Bacman88/TerraLight/schematy/kicad9/TerraLight-mini/podglad.png

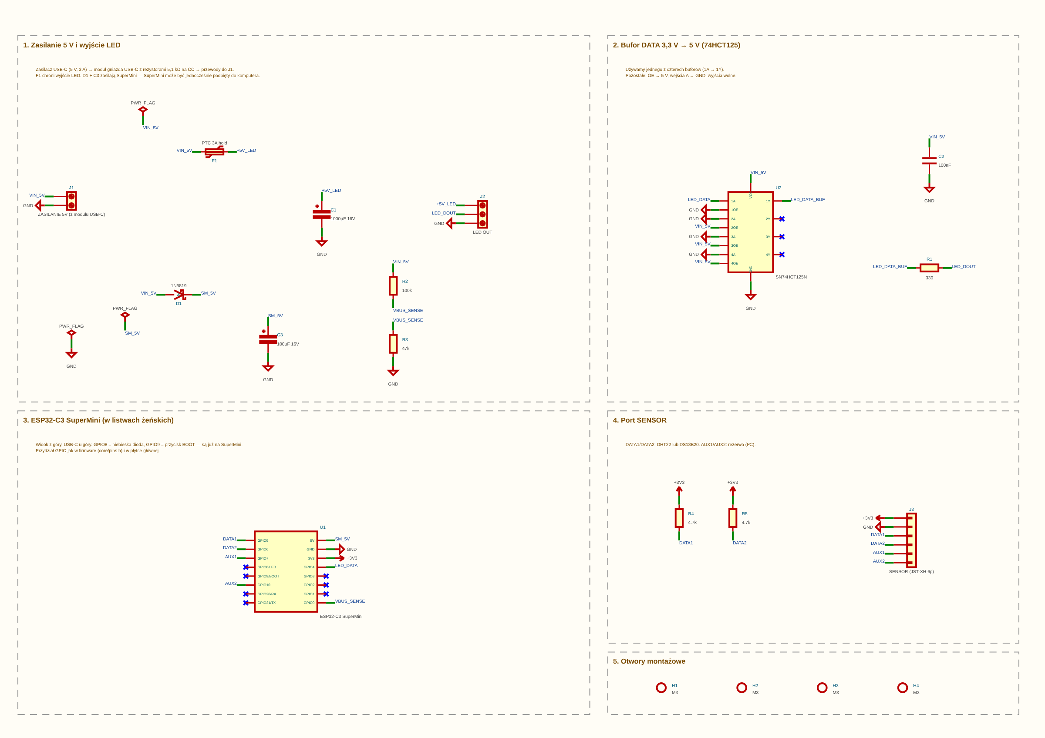
schematy/kicad9/TerraLight-mini/podglad.png
