Bacman88/TerraLight/(list of files, drawings)

Other design files:
schematy/easyeda/TerraLight_Minimal_EasyEDA_STD_DRAFT.json
