Bacman88/TerraLight/schematy/kicad9/TerraLight-main/TerraLight-main.kicad_sch

## KiCad design schematy/kicad9/TerraLight-main/TerraLight-main.kicad_sch (2026-10-15)

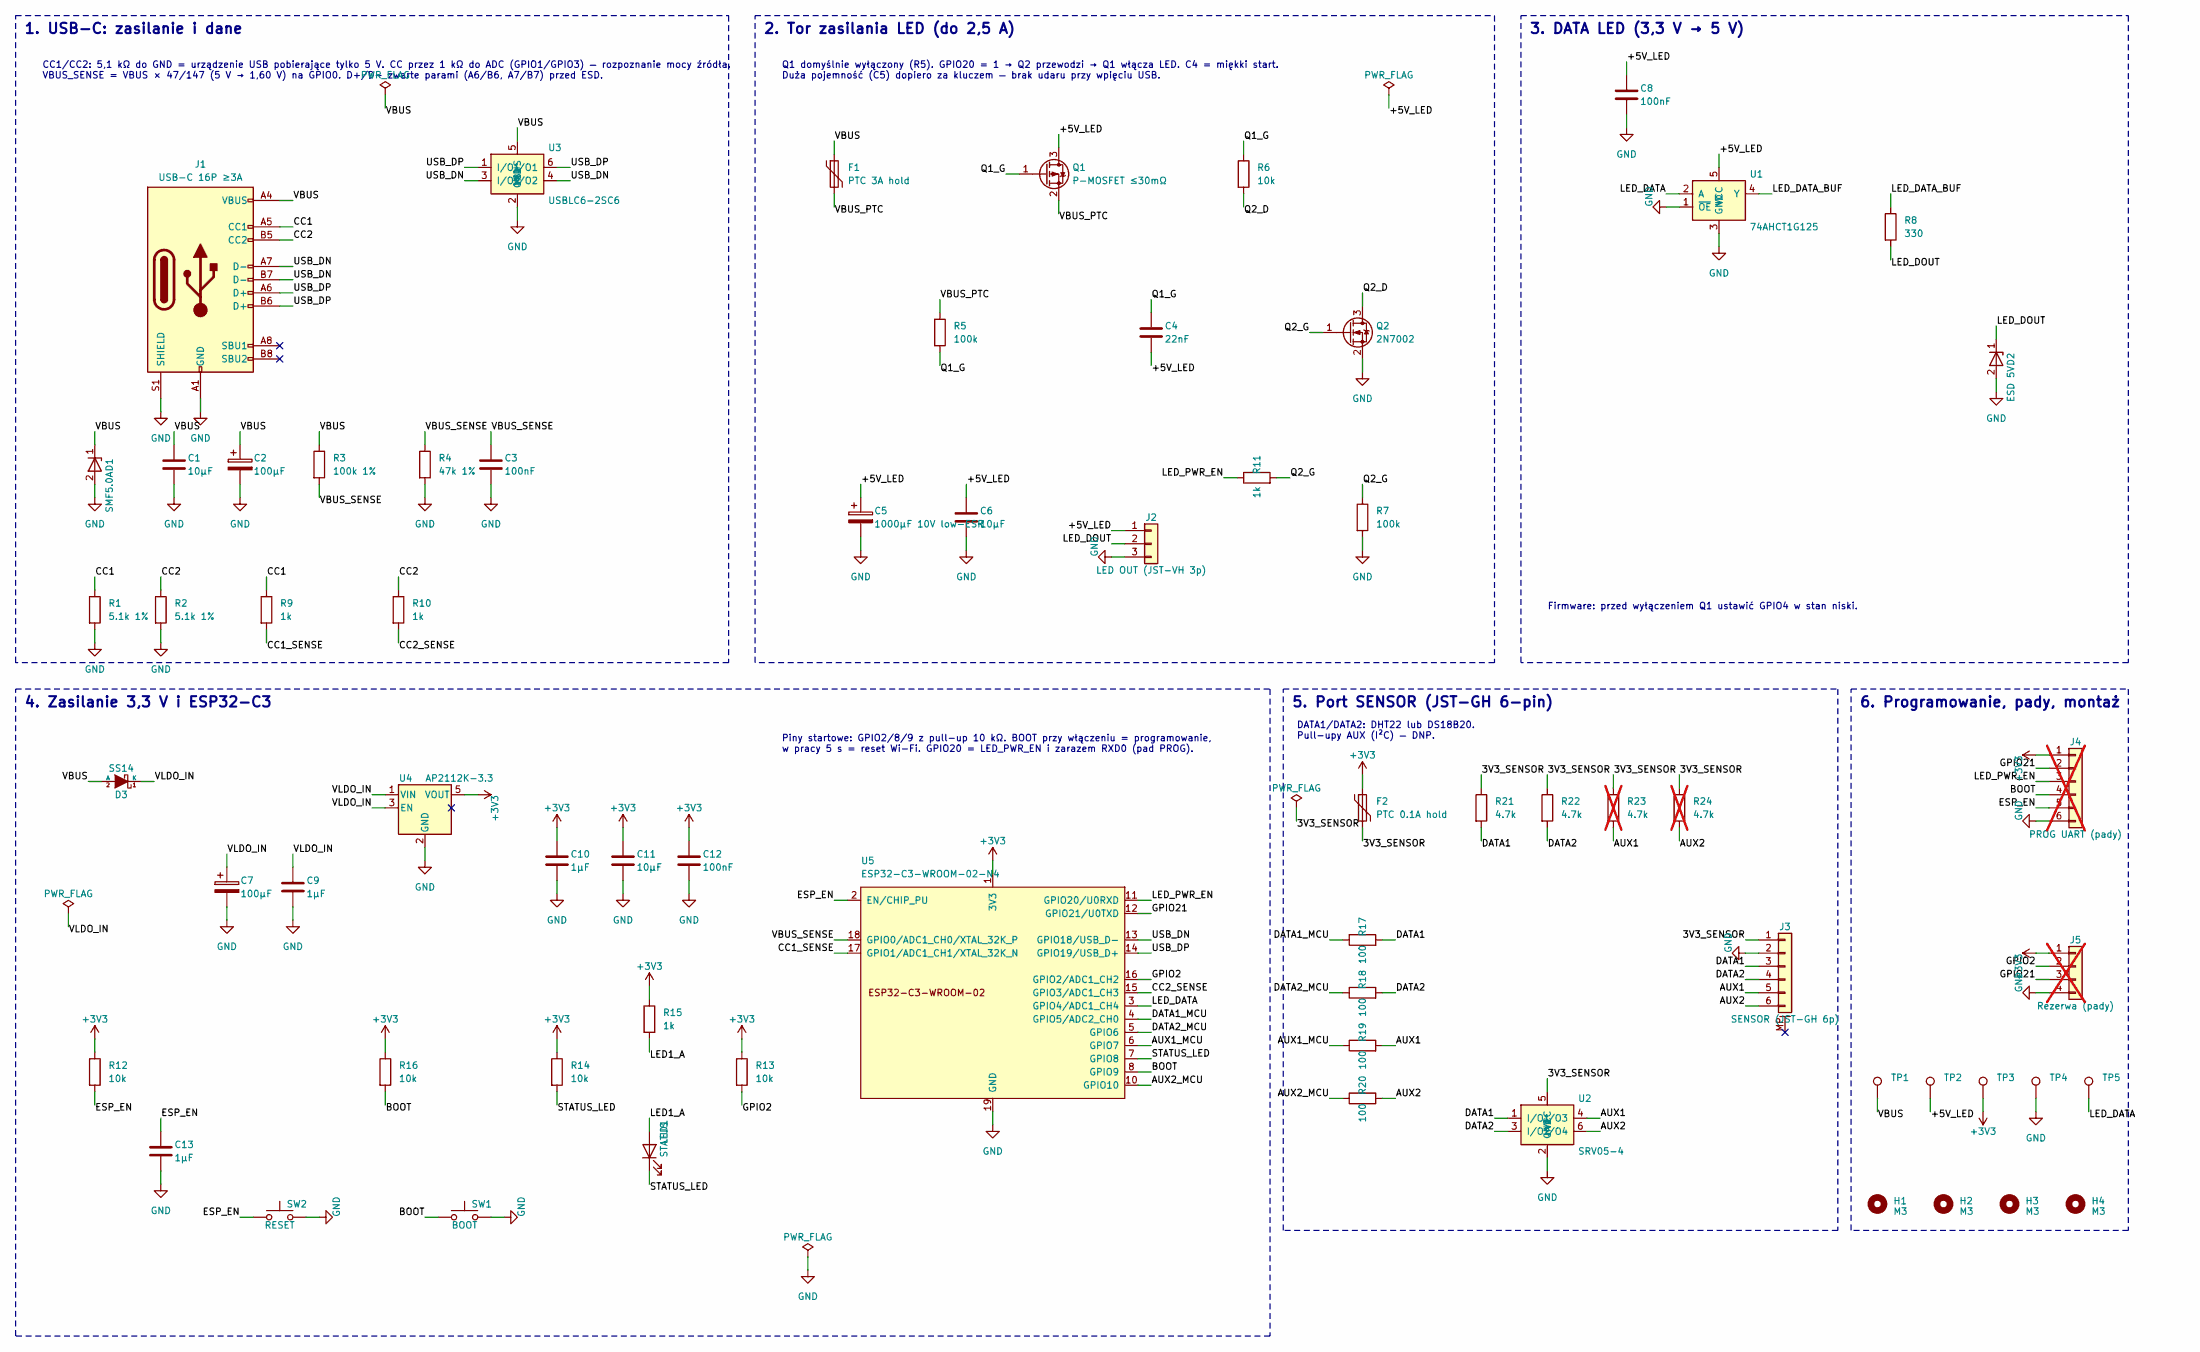
[picture p2: schematic TerraLight-main.kicad_sch]

Parts:
C1, C6, C11: 10µF; C_0805_2012Metric; MPN Samsung CL21A106KAYNNNE
C2, C7: 100µF; CP_Elec_6.3x7.7; MPN [100 µF ≥10 V, SMD Ø6,3 mm]
C3, C8, C12: 100nF; C_0805_2012Metric; MPN Samsung CL21B104KBCNNNC
C4: 22nF; C_0805_2012Metric; MPN Samsung CL21B223KBANNNC
C5: 1000µF 10V low-ESR; CP_Elec_10x10.5; MPN [1000 µF 10 V low-ESR, SMD Ø10 mm]
C9, C10, C13: 1µF; C_0805_2012Metric; MPN Samsung CL21B105KAFNNNE
D1: SMF5.0A; D_SOD-123F; MPN Littelfuse SMF5.0A
D2: ESD 5V; D_SOD-323; MPN Nexperia PESD5V0S1BA
D3: SS14; D_SMA; MPN SS14
F1: PTC 3A hold; Fuse_1812_4532Metric; MPN Bourns MF-MSMF300-2 [lub inny PTC 1812,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
F2: PTC 0.1A hold; Fuse_0805_2012Metric; MPN Littelfuse 0805L010
H1, H2, H3, H4: M3; MountingHole_3.2mm_M3
J1: USB-C 16P ≥3A; USB_C_Receptacle_HRO_TYPE-C-31-M-12; MPN HRO TYPE-C-31-M-12
J2: LED OUT (JST-VH 3p); JST_VH_S3P-VH_1x03_P3.96mm_Horizontal; MPN JST S3P-VH(LF)(SN)
J3: SENSOR (JST-GH 6p); JST_GH_SM06B-GHS-TB_1x06-1MP_P1.25mm_Horizontal; MPN JST SM06B-GHS-TB(LF)(SN)
J4: PROG UART (pady); PinHeader_1x06_P2.54mm_Vertical; MPN [listwa 1×6 2,54 mm — opcjonalnie]; not fitted
J5: Rezerwa (pady); PinHeader_1x04_P2.54mm_Vertical; MPN [listwa 1×4 2,54 mm — opcjonalnie]; not fitted
LED1: STATUS; LED_0805_2012Metric; MPN [LED 0805, dowolny kolor]
Q1: P-MOSFET ≤30mΩ; SOT-23; MPN Vishay Si2333DDS [sprawdzić RDS(on) i p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
Q2: 2N7002; SOT-23; MPN 2N7002
R1, R2: 5.1k 1%; R_0805_2012Metric; MPN Yageo RC0805FR-075K1L
R3: 100k 1%; R_0805_2012Metric; MPN Yageo RC0805FR-07100KL
R4: 47k 1%; R_0805_2012Metric; MPN Yageo RC0805FR-0747KL
R5, R7: 100k; R_0805_2012Metric; MPN Yageo RC0805FR-07100KL
R6, R12, R13, R14, R16: 10k; R_0805_2012Metric; MPN Yageo RC0805FR-0710KL
R8: 330; R_0805_2012Metric; MPN Yageo RC0805FR-07330RL
R9, R10, R11, R15: 1k; R_0805_2012Metric; MPN Yageo RC0805FR-071KL
R17, R18, R19, R20: 100; R_0805_2012Metric; MPN Yageo RC0805FR-07100RL
R21, R22: 4.7k; R_0805_2012Metric; MPN Yageo RC0805FR-074K7L
R23, R24: 4.7k; R_0805_2012Metric; MPN Yageo RC0805FR-074K7L; not fitted
SW1: BOOT; SW_SPST_TL3342; MPN E-Switch TL3342 [sprawdzić wariant]
SW2: RESET; SW_SPST_TL3342; MPN E-Switch TL3342 [sprawdzić wariant]
TP1: VBUS; TestPoint_Pad_D1.5mm
TP2: +5V_LED; TestPoint_Pad_D1.5mm
TP3: +3V3; TestPoint_Pad_D1.5mm
TP4: GND; TestPoint_Pad_D1.5mm
TP5: LED_DATA; TestPoint_Pad_D1.5mm
U1: 74AHCT1G125; SOT-23-5; MPN TI SN74AHCT1G125DBVR
U2: SRV05-4; SOT-23-6; MPN Semtech SRV05-4
U3: USBLC6-2SC6; SOT-23-6; MPN ST USBLC6-2SC6
U4: AP2112K-3.3; SOT-23-5; MPN Diodes AP2112K-3.3TRG1
U5: ESP32-C3-WROOM-02-N4; ESP32-C3-WROOM-02_HandSolder; MPN Espressif ESP32-C3-WROOM-02-N4

Connections:
3V3_SENSOR: F2.2, J3.1, R21.1, R22.1, R23.1, R24.1, U2.5 (VCC)
+3V3: C10.1, C11.1, C12.1, F2.1, J4.1, J5.1, R12.1, R13.1, R14.1, R15.1, R16.1, TP3.1, U4.5 (VOUT), U5.1 (3V3)
+5V_LED: C4.2, C5.1, C6.1, C8.1, J2.1, Q1.3 (D), TP2.1, U1.5 (VCC)
AUX1: J3.5, R19.2, R23.2, U2.4 (I/O3)
AUX1_MCU: R19.1, U5.6 (GPIO7)
AUX2: J3.6, R20.2, R24.2, U2.6 (I/O4)
AUX2_MCU: R20.1, U5.10 (GPIO10)
BOOT: J4.4, R16.2, SW1.1, U5.8 (GPIO9)
CC1: J1.A5 (CC1), R1.1, R9.1
CC1_SENSE: R9.2, U5.17 (GPIO1/ADC1_CH1/XTAL_32K_N)
CC2: J1.B5 (CC2), R2.1, R10.1
CC2_SENSE: R10.2, U5.15 (GPIO3/ADC1_CH3)
DATA1: J3.3, R17.2, R21.2, U2.1 (I/O1)
DATA1_MCU: R17.1, U5.4 (GPIO5/ADC2_CH0)
DATA2: J3.4, R18.2, R22.2, U2.3 (I/O2)
DATA2_MCU: R18.1, U5.5 (GPIO6)
ESP_EN: C13.1, J4.5, R12.2, SW2.1, U5.2 (EN/CHIP_PU)
GND: C1.2, C2.2, C3.2, C5.2, C6.2, C7.2, C8.2, C9.2, C10.2, C11.2, C12.2, C13.2, D1.2 (A), D2.2 (A), J1.A1 (GND), J1.A12 (GND), J1.B1 (GND), J1.B12 (GND), J1.S1 (SHIELD), J2.3, J3.2, J4.6, J5.4, Q2.2 (S), R1.2, R2.2, R4.2, R7.2, SW1.2, SW2.2, TP4.1, U1.1 (~OE), U1.3 (GND), U2.2 (GND), U3.2 (GND), U4.2 (GND), U5.9 (GND), U5.19 (GND)
GPIO2: J5.2, R13.2, U5.16 (GPIO2/ADC1_CH2)
GPIO21: J4.2, J5.3, U5.12 (GPIO21/U0TXD)
LED1_A: LED1.2 (A), R15.2
LED_DATA: TP5.1, U1.2 (A), U5.3 (GPIO4/ADC1_CH4)
LED_DATA_BUF: R8.1, U1.4 (Y)
LED_DOUT: D2.1 (K), J2.2, R8.2
LED_PWR_EN: J4.3, R11.1, U5.11 (GPIO20/U0RXD)
Q1_G: C4.1, Q1.1 (G), R5.2, R6.1
Q2_D: Q2.3 (D), R6.2
Q2_G: Q2.1 (G), R7.1, R11.2
STATUS_LED: LED1.1 (K), R14.2, U5.7 (GPIO8)
USB_DN: J1.A7 (D-), J1.B7 (D-), U3.3 (I/O2), U3.4 (I/O2), U5.13 (GPIO18/USB_D-)
USB_DP: J1.A6 (D+), J1.B6 (D+), U3.1 (I/O1), U3.6 (I/O1), U5.14 (GPIO19/USB_D+)
VBUS: C1.1, C2.1, D1.1 (K), D3.2 (A), F1.1, J1.A4 (VBUS), J1.A9 (VBUS), J1.B4 (VBUS), J1.B9 (VBUS), R3.1, TP1.1, U3.5 (VBUS)
VBUS_PTC: F1.2, Q1.2 (S), R5.1
VBUS_SENSE: C3.1, R3.2, R4.1, U5.18 (GPIO0/ADC1_CH0/XTAL_32K_P)
VLDO_IN: C7.1, C9.1, D3.1 (K), U4.1 (VIN), U4.3 (EN)

Notes on the sheet:
1. USB-C: zasilanie i dane
2. Tor zasilania LED (do 2,5 A)
3. DATA LED (3,3 V → 5 V)
4. Zasilanie 3,3 V i ESP32-C3
5. Port SENSOR (JST-GH 6-pin)
6. Programowanie, pady, montaż
CC1/CC2: 5,1 kΩ do GND = urządzenie USB pobierające tylko 5 V. CC przez 1 kΩ do ADC (GPIO1/GPIO3) — rozpoznanie mocy źródła. VBUS_SENSE = VBUS × 47/147 (5 V → 1,60 V) na GPIO0. D+/D- zwarte parami (A6/B6, A7/B7) przed ESD.
Q1 domyślnie wyłączony (R5). GPIO20 = 1 → Q2 przewodzi → Q1 włącza LED. C4 = miękki start. Duża pojemność (C5) dopiero za kluczem — brak udaru przy wpięciu USB.
Firmware: przed wyłączeniem Q1 ustawić GPIO4 w stan niski.
Piny startowe: GPIO2/8/9 z pull-up 10 kΩ. BOOT przy włączeniu = programowanie, w pracy 5 s = reset Wi-Fi. GPIO20 = LED_PWR_EN i zarazem RXD0 (pad PROG).
DATA1/DATA2: DHT22 lub DS18B20. Pull-upy AUX (I²C) — DNP.
