Bacman88/TerraLight/schematy/kicad9/TerraLight-mini/TerraLight-mini.kicad_sch

## KiCad design schematy/kicad9/TerraLight-mini/TerraLight-mini.kicad_sch (2026-10-15)

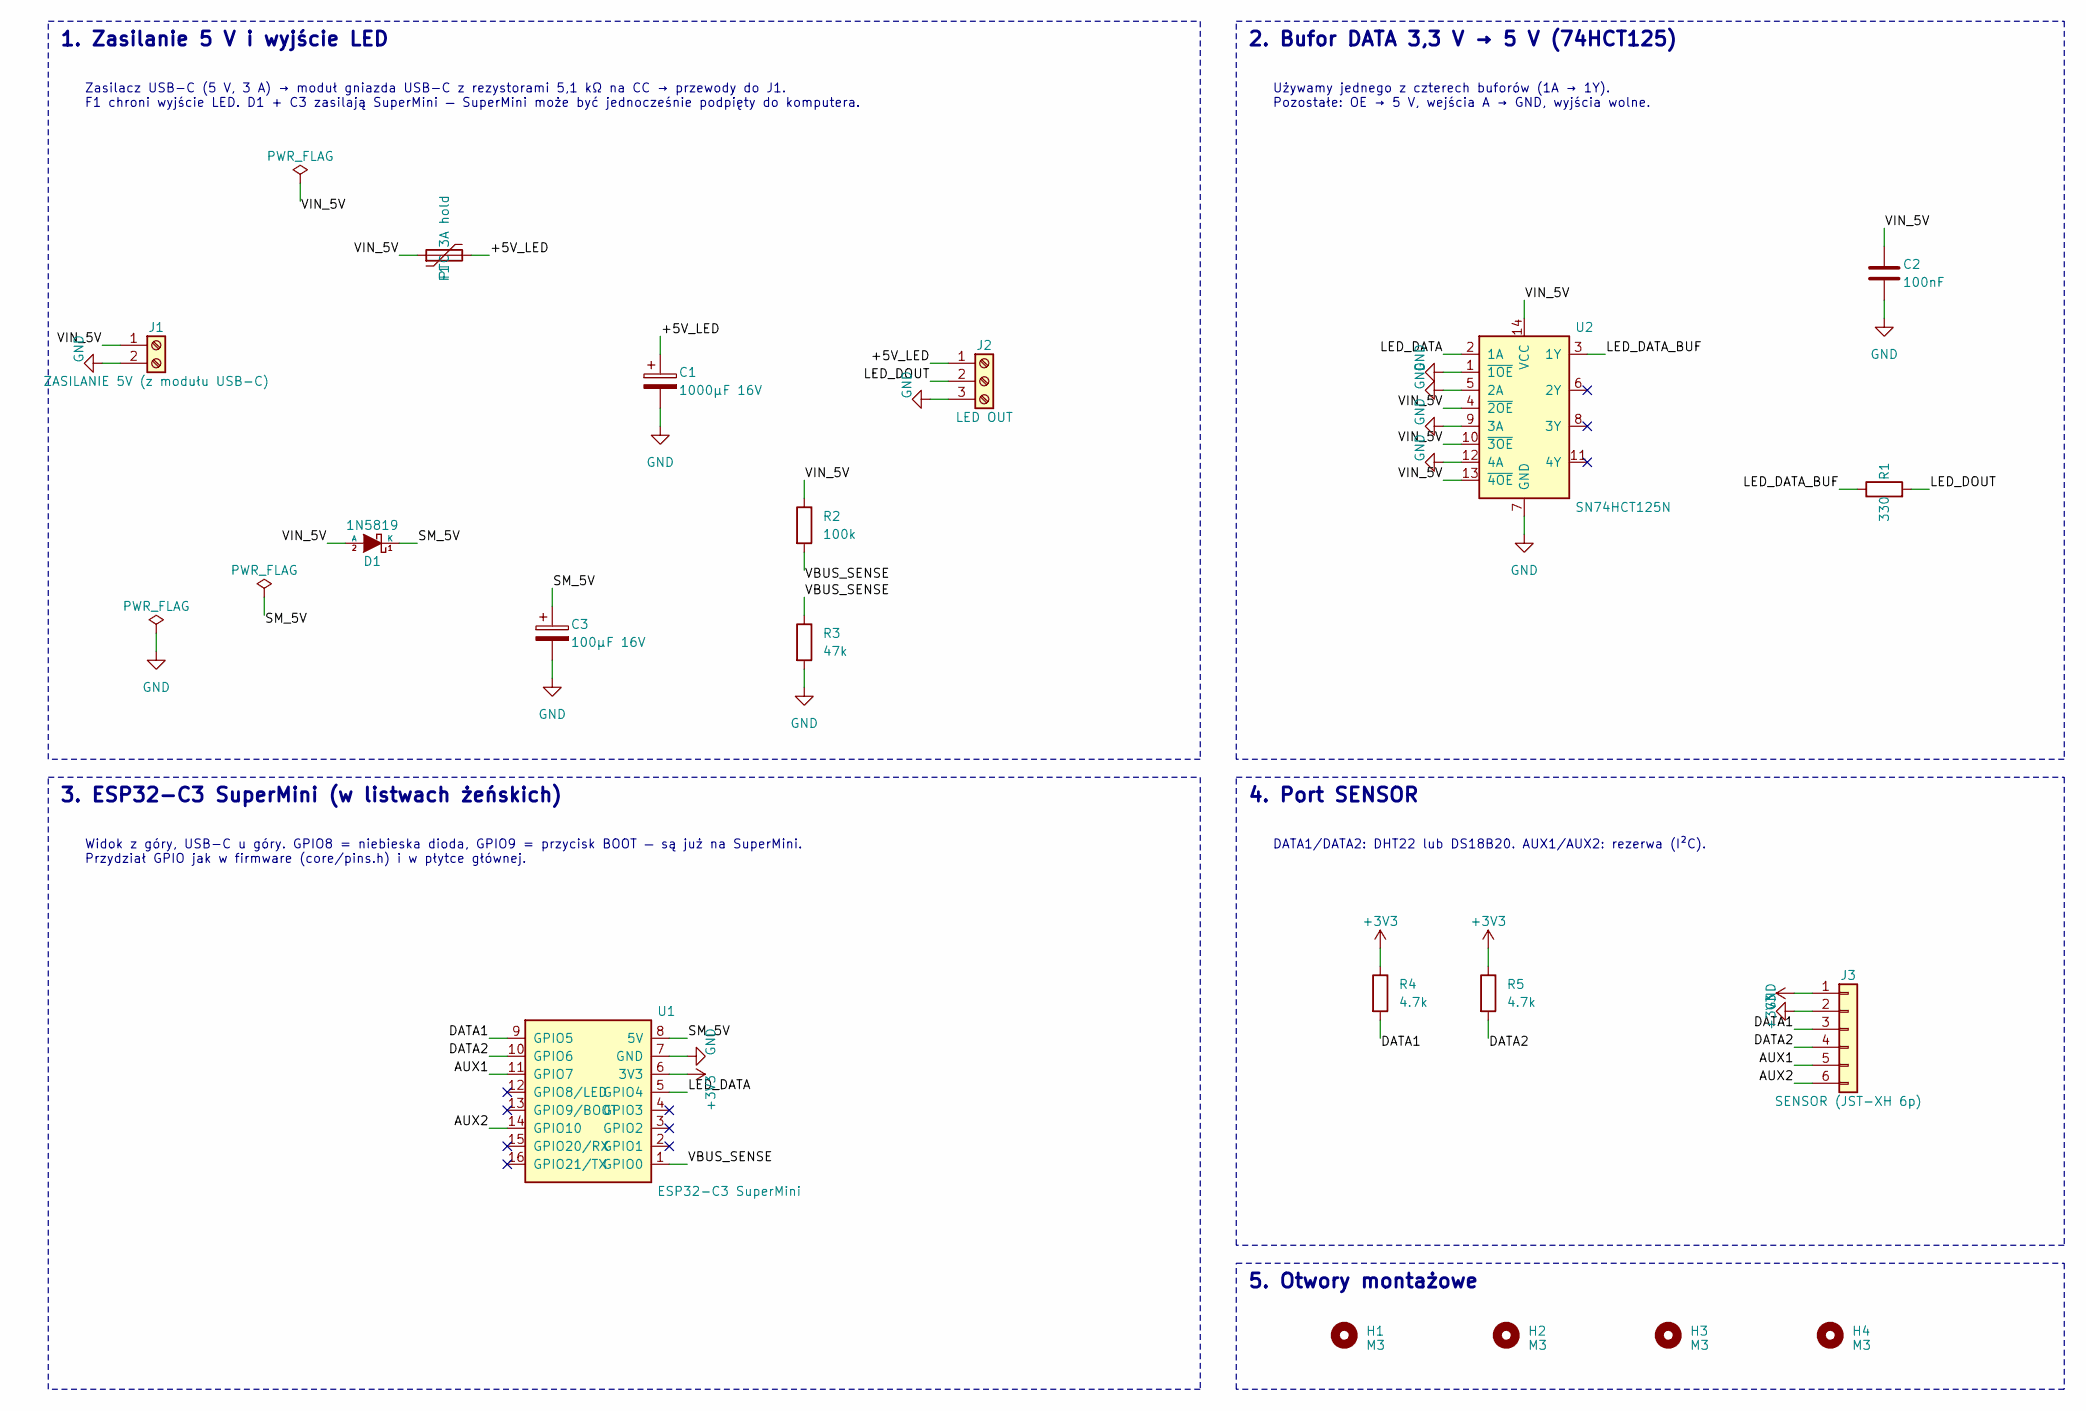
[picture p3: schematic TerraLight-mini.kicad_sch]

Parts:
C1: 1000µF 16V; CP_Radial_D10.0mm_P5.00mm; MPN [1000 µF 16 V, przewlekany Ø10 mm, rast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
C2: 100nF; C_Disc_D5.0mm_W2.5mm_P5.00mm; MPN kondensator ceramiczny THT 100 nF 50 V,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
C3: 100µF 16V; CP_Radial_D6.3mm_P2.50mm; MPN [100 µF 16 V, przewlekany Ø6,3 mm, rast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
D1: 1N5819; D_DO-41_SOD81_P10.16mm_Horizontal; MPN 1N5819
F1: PTC 3A hold; Fuse_Bourns_MF-RG300; MPN Bourns MF-RG300 [PTC 3 A hold, przewlek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
H1, H2, H3, H4: M3; MountingHole_3.2mm_M3
J1: ZASILANIE 5V (z modułu USB-C); TerminalBlock_Phoenix_MKDS-1,5-2-5.08_1x02_P5.08mm_Horizont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; MPN zacisk ARK 2-pin 5,08 mm (np. Phoenix M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
J2: LED OUT; TerminalBlock_Phoenix_MKDS-1,5-3-5.08_1x03_P5.08mm_Horizont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; MPN zacisk ARK 3-pin 5,08 mm (np. Phoenix M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
J3: SENSOR (JST-XH 6p); JST_XH_B6B-XH-A_1x06_P2.50mm_Vertical; MPN JST B6B-XH-A (+ wtyk XHP-6 z przewodami)
R1: 330; R_Axial_DIN0207_L6.3mm_D2.5mm_P10.16mm_Horizontal; MPN rezystor 0,25 W 1% THT 330 Ω
R2: 100k; R_Axial_DIN0207_L6.3mm_D2.5mm_P10.16mm_Horizontal; MPN rezystor 0,25 W 1% THT 100 kΩ
R3: 47k; R_Axial_DIN0207_L6.3mm_D2.5mm_P10.16mm_Horizontal; MPN rezystor 0,25 W 1% THT 47 kΩ
R4, R5: 4.7k; R_Axial_DIN0207_L6.3mm_D2.5mm_P10.16mm_Horizontal; MPN rezystor 0,25 W 1% THT 4,7 kΩ
U1: ESP32-C3 SuperMini; ESP32-C3-SuperMini_Socket; MPN ESP32-C3 SuperMini (+ 2× listwa żeńska 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
U2: SN74HCT125N; DIP-14_W7.62mm_Socket; MPN TI SN74HCT125N (+ podstawka DIP-14)

Connections:
+3V3: J3.1, R4.1, R5.1, U1.6 (3V3)
+5V_LED: C1.1, F1.2, J2.1
AUX1: J3.5, U1.11 (GPIO7)
AUX2: J3.6, U1.14 (GPIO10)
DATA1: J3.3, R4.2, U1.9 (GPIO5)
DATA2: J3.4, R5.2, U1.10 (GPIO6)
GND: C1.2, C2.2, C3.2, J1.2, J2.3, J3.2, R3.2, U1.7 (GND), U2.1 (~1OE), U2.5 (2A), U2.7 (GND), U2.9 (3A), U2.12 (4A)
LED_DATA: U1.5 (GPIO4), U2.2 (1A)
LED_DATA_BUF: R1.1, U2.3 (1Y)
LED_DOUT: J2.2, R1.2
SM_5V: C3.1, D1.1 (K), U1.8 (5V)
VBUS_SENSE: R2.2, R3.1, U1.1 (GPIO0)
VIN_5V: C2.1, D1.2 (A), F1.1, J1.1, R2.1, U2.4 (~2OE), U2.10 (~3OE), U2.13 (~4OE), U2.14 (VCC)

Notes on the sheet:
1. Zasilanie 5 V i wyjście LED
2. Bufor DATA 3,3 V → 5 V (74HCT125)
3. ESP32-C3 SuperMini (w listwach żeńskich)
4. Port SENSOR
5. Otwory montażowe
Zasilacz USB-C (5 V, 3 A) → moduł gniazda USB-C z rezystorami 5,1 kΩ na CC → przewody do J1. F1 chroni wyjście LED. D1 + C3 zasilają SuperMini — SuperMini może być jednocześnie podpięty do komputera.
Używamy jednego z czterech buforów (1A → 1Y). Pozostałe: OE → 5 V, wejścia A → GND, wyjścia wolne.
Widok z góry, USB-C u góry. GPIO8 = niebieska dioda, GPIO9 = przycisk BOOT — są już na SuperMini. Przydział GPIO jak w firmware (core/pins.h) i w płytce głównej.
DATA1/DATA2: DHT22 lub DS18B20. AUX1/AUX2: rezerwa (I²C).
