Bacman88/TerraLight/(commit log)

2026-10-13 docs: add docs/SENSOR_MINI.md
2026-10-13 docs: add docs/LED_MODULES.md
2026-10-13 docs: add Wi-Fi reset button (BOOT/GPIO9) and firmware v2.0 decisions
    Claude-Session: https://claude.ai/code/session_011xrhtcpPCLVqz5j5FtXSAa
2026-10-13 docs: add Aqua mode (caustics, siesta, biotopes, service mode) and DS18B20 probe on AUX1
    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
2026-10-13 docs: DS18B20 replaces DHT22 on DATA1/DATA2, keep AUX free for I2C
    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
2026-10-13 docs: per-channel sensor type (DHT22 / DS18B20 / none) with paludarium example
    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
2026-10-13 docs: DS18B20 for basking-spot surface temperature in Terra
    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
2026-10-13 hardware: require 5V HCT LED data buffer and align sensor docs
2026-10-13 docs: stay with Arduino IDE for now, compile check via arduino-cli
    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
2026-10-13 firmware: M1 skeleton (2.0.0-dev.1)
    PlatformIO project for ESP32-C3 SuperMini (pioarduino, core 3.3.12):
    - settings in NVS with schema version and deferred save
    - clock with POSIX time zone (fixes year-round UTC+2 bug), time from phone
    - non-blocking Wi-Fi state machine; setup AP + captive portal keep the light running;
    no automatic fallback to AP when the saved network is down
    - BOOT (GPIO9) held 5 s forgets Wi-Fi; onboard LED shows Wi-Fi state
    - LED output: module presets, colour order (RGB default), density, gamma,
    current limiter, soft start, smooth transitions
    - static light scene, web panel PL/EN (embedded gzip) and REST API
    - min_spiffs partitions (1.9 MB OTA slots)
    Compile-check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
    [api_json.cpp, api_json.h, button.cpp, button.h, clock.cpp, clock.h]
2026-10-14 Make assets.h reproducible across machines; note PLATFORMIO_CORE_DIR
    Newer Python writes the host OS into the gzip header, so assets.h
    differed between computers. Pin the OS byte to 0xFF (unknown).
    Document the PLATFORMIO_CORE_DIR workaround for Windows long paths
    and record the first M1 build result in Status.
2026-10-14 Fix Wi-Fi setup, add AP first-run wizard, restyle panel
    - Fix unsigned timer comparisons: loop() takes `now` before handling
    HTTP, so a start time set by a request made `now - start` wrap and
    the Wi-Fi test failed instantly; settings saves were not deferred.
    - Log and report the router's disconnect reason (serial + panel),
    stop a running scan before connecting.
    - Panel: show-password toggle, picking a network fills the SSID field.
    - First-run wizard in setup AP only: Wi-Fi (skippable), then LED count
    and power supply. AP stays up until the wizard finishes.
    - SETTINGS_SCHEMA 2 adds system.setupDone; migration from 1 sets it
    true so configured devices skip the wizard after OTA.
    - Res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
    [api_json.cpp, main.cpp, server.cpp, settings.cpp, settings.h, wifi_manager.cpp, wifi_manager.h]
2026-10-14 Add OTA updates from GitHub Releases without a token (2.0.0-dev.2)
    - net/ota: reads releases/latest/download/manifest.json, downloads
    releases/download/<tag>/firmware.bin into the other slot, checks
    size and SHA-256. HTTPS with the built-in CA bundle. Runs in its own
    FreeRTOS task so the light keeps running.
    - Auto check 30 s after Wi-Fi comes up and every 24 h; install from
    the panel (POST /api/ota/check, /api/ota/update; "ota" in status).
    - Rollback: a new image is confirmed after 60 s of running, a reset
    before that boots the previous version.
    - tools/make_release.py builds the release assets; release notes in
    CLAUDE.md and ARCHITECTURE.md.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
    [main.cpp, ota.cpp, ota.h, server.cpp]
2026-10-14 Add hard LED current limits; power via USB-C (2.0.0-dev.4)
    - LED_OUT_MAX_MA = 2500: the LED budget never exceeds the board limit
    (API, settings load, and again in the limiter). mA/pixel is limited
    to 10-120 so the estimate cannot be fooled by a tiny value.
    - Fix the limiter turning off when the idle draw of a long chain
    exceeded the budget; colours now go dark instead.
    - Wizard offers supplies up to 5 V / 3 A only, with a hint.
    - HARDWARE.md: "Granice" section with the limits, what firmware cannot
    catch, required protections, and the USB-C (no PD) power decision.
    [api_json.cpp, led_output.cpp, settings.cpp, settings.h]
2026-10-14 docs: draft customer guide for power supply and compatible LEDs
2026-10-15 docs: main lamp (UVB) cooperation option; Sensor PRO outputs
    TerraLight can fade out for full day and only do dawn, dusk and night
    while a UVB / aquarium lamp runs (Terra and Aqua). Lamp timer is set by
    the user (easiest with fixed hours) or switched by Sensor PRO, which
    gets two outputs: heating and UVB / night lamp.
2026-10-15 docs: PCB design proposal with ESP32-C3-MINI-1 module
    Production board: module soldered on, one USB-C 16-pin for power and
    programming, CC/VBUS sensing on ADC, LED power switch with soft start
    on GPIO20, ESD on all external lines, JLCPCB SMD assembly and a rough
    cost estimate. Open decisions listed in docs/PCB.md.
2026-10-15 docs: PCB decisions - JST-SM pigtail, LED power switch, built-in antenna
2026-10-15 docs: PCB - LED wire solder holes, 3D-printed case
2026-10-15 docs: LED OUT as JST-VH 3-pin header with VH to JST-SM adapter cable
2026-10-15 docs: adapter cable ends in a female JST-SM plug
2026-10-15 hardware: KiCad 9 schematic of the main board (per docs/PCB.md v0.2)
    Single A3 sheet, six blocks: USB-C power/data, switched LED power path,
    LED DATA buffer, 3.3 V + ESP32-C3-MINI-1, SENSOR port, programming pads.
    Project-local symbol library (KiCad 9 standard symbols + Espressif module)
    and ESP32-C3-MINI-1 footprint, so no extra libraries are needed.
    Connectivity verified by script: 53 nets, no unconnected pins, no dangling
    wires. ERC in KiCad and part selection still to do (see README).
    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
    [TerraLight-main.kicad_sch]
2026-10-15 docs: note KiCad schematic in CLAUDE.md status
    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
2026-10-15 docs: organize TerraLight breadboard and PCB schematics guidance
2026-10-15 schematics: add editable EasyEDA minimal breadboard draft
    [TerraLight_Minimal_EasyEDA_STD_DRAFT.json]
2026-10-15 schematics: add minimal breadboard BOM
    [BOM_MINIMUM.csv]
2026-10-15 schematy: fix KiCad file syntax, right-angle LED OUT connector, move project to schematy/kicad9
    - the generator quoted every S-expression keyword ("kicad_sch" instead of
    kicad_sch), so KiCad could not open the file; keywords are now bare and
    atom quoting was checked against files saved by KiCad 9
    - J2 LED OUT: JST S3P-VH right-angle footprint, so all cables leave from
    the board edge
    - project moved from hardware/kicad/ to schematy/kicad9/TerraLight-main/,
    links updated
    Connectivity unchanged: 53 nets, 0 unconnected pins.
    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
    [TerraLight-main.kicad_sch]
2026-10-15 schematy: 0805 passives for hand assembly, MPN fields, BOM for 5 prototypes
    Prototypes will be assembled by hand (stencil + hot air), so all small
    passives move from 0402 to 0805 and the status LED to 0805. Every part
    gets an MPN field; BOM_prototyp_5szt.csv lists quantities for a batch of
    five with spares. Connectivity unchanged (53 nets, 0 unconnected).
    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
    [BOM_prototyp_5szt.csv, TerraLight-main.kicad_sch]
2026-10-15 schematy: ESP32-C3-WROOM-02 for hand-soldered prototypes
    The owner assembles the first boards by hand, so the module changes from
    ESP32-C3-MINI-1 (pads only underneath, needs hot air) to
    ESP32-C3-WROOM-02-N4 with castellated edge pads. The footprint is
    Espressif's with one plated hole in the GND pad so it can be soldered
    from the bottom with an iron. GPIO assignment is unchanged (checked pin
    by pin against docs/PCB.md); firmware needs no changes.
    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
    [BOM_prototyp_5szt.csv, TerraLight-main.kicad_sch]
2026-10-15 schematy: TerraLight MINI beginner board (SuperMini on headers, all THT)
    The SMD main board is a lot for a first build, so add a simple carrier
    board: ESP32-C3 SuperMini plugged into two 1x8 female headers and only
    through-hole parts. It is the breadboard circuit on a PCB plus a 3 A PTC
    on LED OUT, a 1N5819 into the SuperMini 5V pin (no backfeed into a PC on
    USB), screw terminals for power in and LED out, the VBUS divider on GPIO0
    and a JST-XH SENSOR port. GPIOs match firmware/src/core/pins.h.
    Generated with the same script as the main board; connectivity checked
    (14 nets, 0 unconnected pins). The SuperMini footprint assumes rows
    15.24 mm apart; the README asks to check this on the real boa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
    [BOM_prototyp_5szt.csv, TerraLight-mini.kicad_sch]
