Bacman88/TerraLight/(notices)

Notices in the files:
schematy/kicad9/TerraLight-main/TerraLight-main.kicad_sch:
Licencja: MIT (projekt), symbol/footprint ESP32-C3-WROOM-02: Espressif CC-BY-SA 4.0
